Silviuu24/Proiect-uC-Termostat-Camera/Tema_04_Etaje_de_Alimentare_si_Analiza_Microcontrolerelor/Imagini/Pini_PIC16F877A.jpg

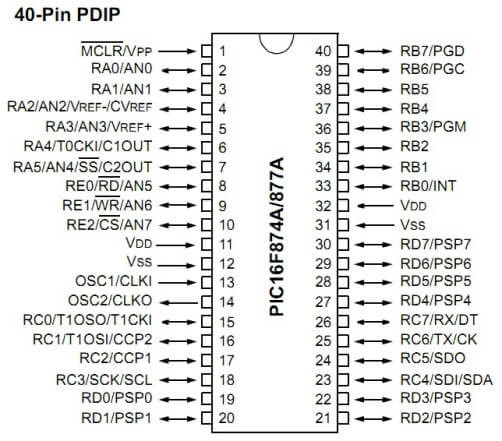
Tema_04_Etaje_de_Alimentare_si_Analiza_Microcontrolerelor/Imagini/Pini_PIC16F877A.jpg
