Silviuu24/Proiect-uC-Termostat-Camera/README.md

# Proiect-uC-Termostat-Camera
Proiect universitar (Anul III) - Microprocesoare: Proiectarea și simularea iterativă a unui termostat de cameră digital.
