Silviuu24/Proiect-uC-Termostat-Camera/Tema_06_Releu/Releu.pptx

## Implementarea Releului și Logica Software pentru Controlul cu Histereză

Nume: Șișca Silviu-Claudiu
An III, gr. 2133

## Cuprins

1. Cerința proiectului
2. Implementarea sistemului de comandă
3. Logica de comandă a butoanelor
4. Algoritm de control – Histereza
5. Simulări

## 1. Cerința proiectului

- Implementare sistem de comandă
- Implementare Butoane
- Cod C & Assembly

## 2. Implementarea sistemului de comandă

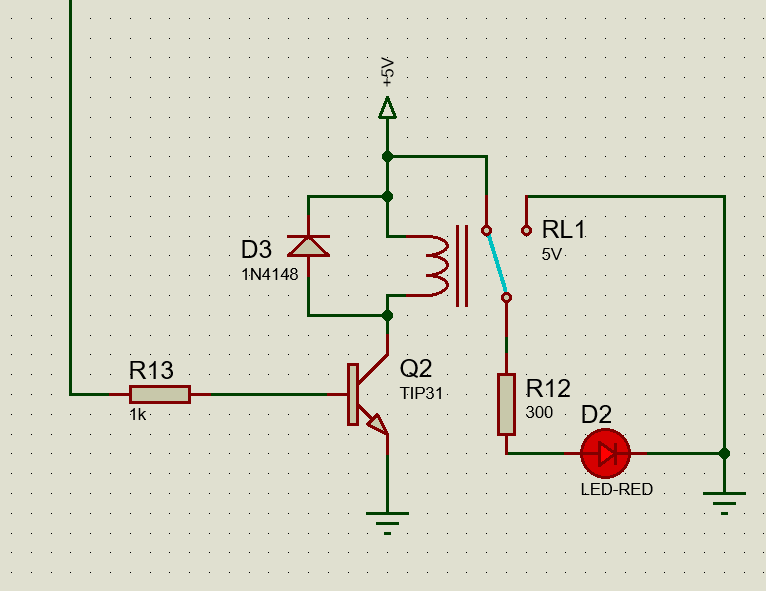
[picture p2: figure]

Tranzistor de comutație
Rezistență de bază
Dioda de protecție
Circuit de sarcină simulat

## 3. Logica de comandă a butoanelor

Modifică valoarea de referință
Limitare valoare de referință: 10°C - 30°C
2 întreruperi
Necesită implementare Debouncing

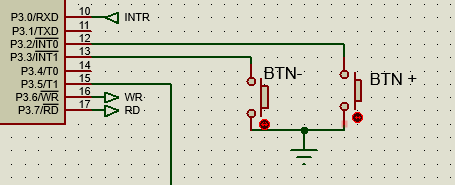
[picture p3: figure]

## 3. Logica de comandă a butoanelor

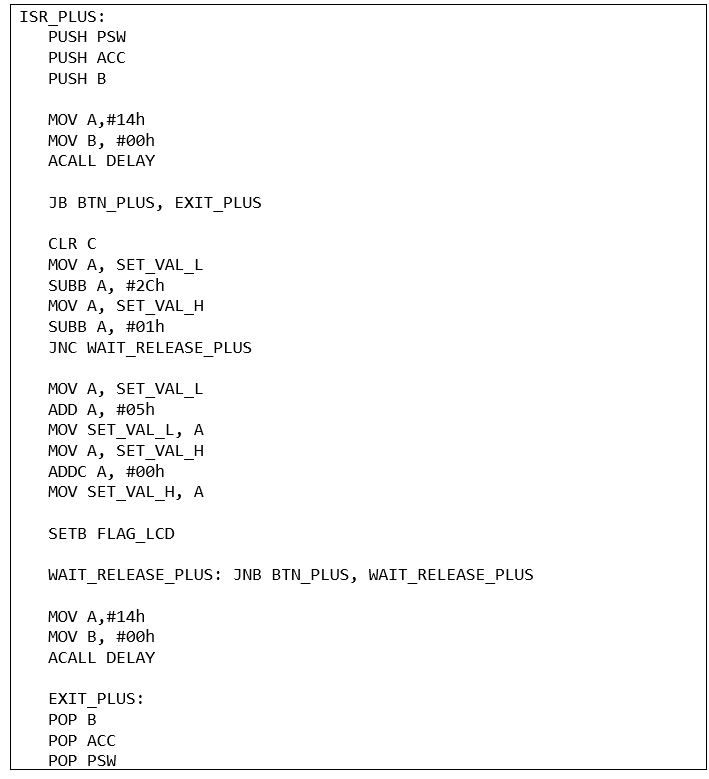
[picture p4: figure]
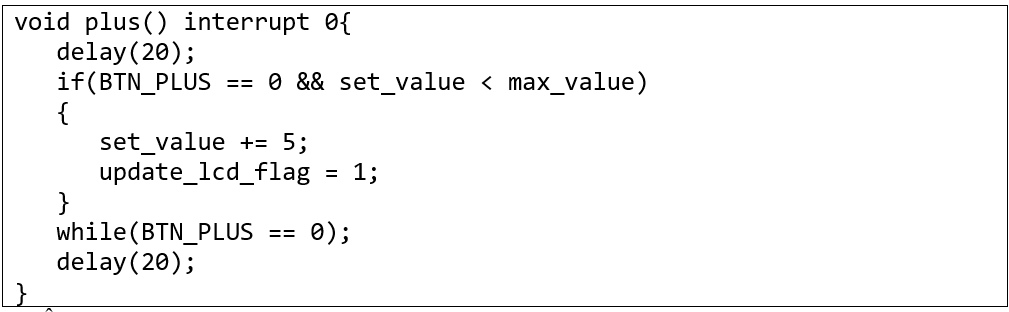
[picture p5: figure]

## 3. Logica de comandă a butoanelor

Dezactivare interrupt

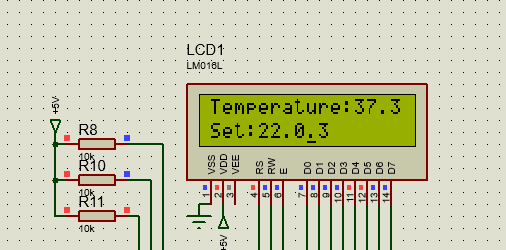
[picture p6: figure]

## 4. Algoritm de control - Histereza

±0.5°C
în C, structură decizională ‘if-else if’
în Assembly, scădere cu împrumut și verificare Carry Flag

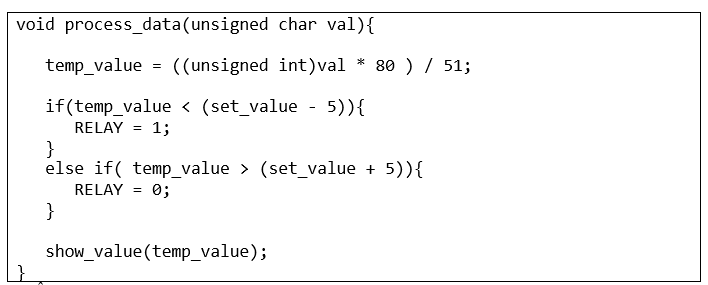
[picture p7: figure]

## 5. Simulări

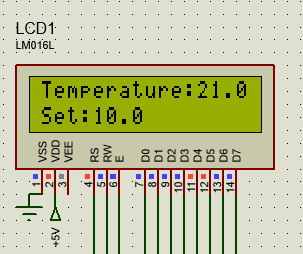
[picture p8: figure]
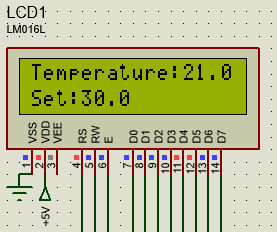
[picture p9: figure]

## 5. Simulări

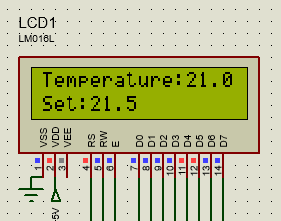
[picture p10: figure]
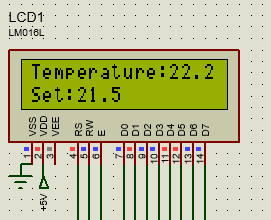
[picture p11: figure]
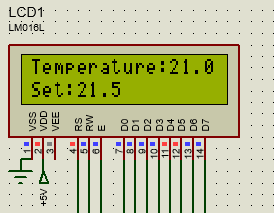
[picture p12: figure]
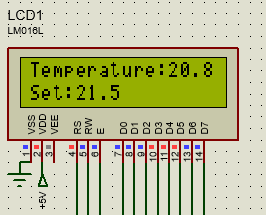
[picture p13: figure]
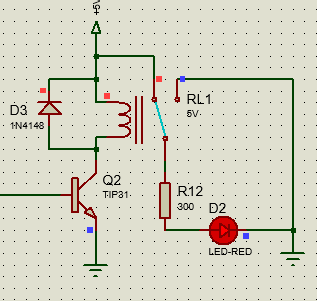
[picture p14: figure]
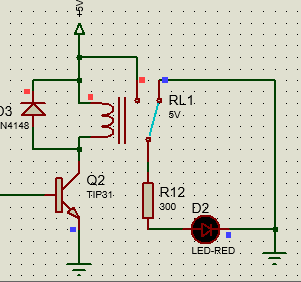
[picture p15: figure]
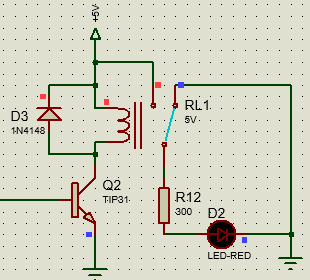
[picture p16: figure]
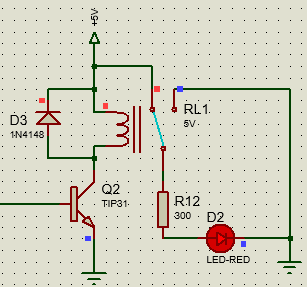
[picture p17: figure]

## Slide 11

Vă mulțumesc pentru atenție!
