Silviuu24/Proiect-uC-Termostat-Camera/Tema_05_uC_Code/uC_Code.pptx

## Sistem de Achiziție, Procesare și Afișare a Temperaturii folosind Microcontrolerul 8051

Nume: Șișca Silviu-Claudiu
An III, gr. 2133

## Cuprins

1. Cerința proiectului
2. Diagrama bloc de funcționare
3. Preluarea datelor de la ADC
4. Interpretarea datelor
5. Afișarea datelor pe LCD
6. Simulări

## 1. Cerința proiectului

- Cod C & Assembly
- Preluarea, interpretarea și afișarea datelor

## 2. Diagrama bloc de funcționare

- 2 etape principale
  - Etapa de inițializare
  - Bucla principală de funcționare

## Slide 5

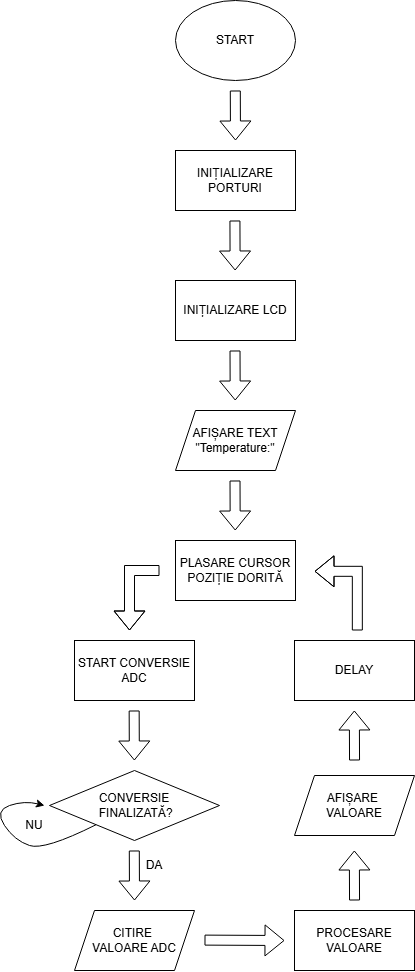
[picture p18: figure]

## 3. Preluarea datelor de la ADC

3 pași consecutivi
Începere conversie
Polling pin întrerupere
Activare ieșire ADC & citire date

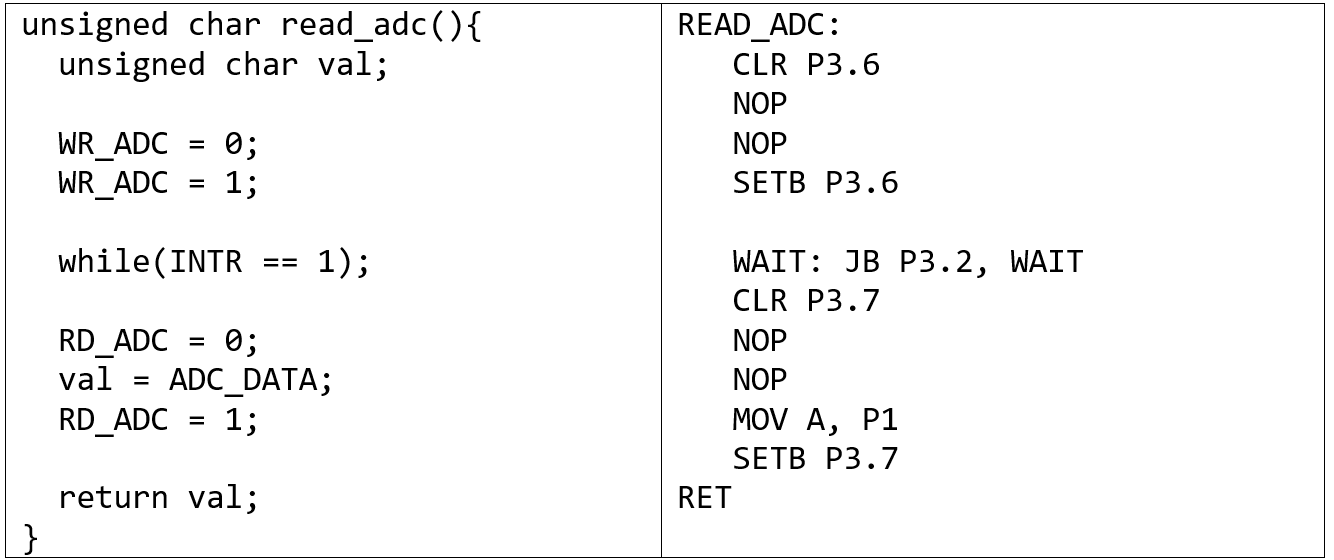
[picture p19: figure]

## 4. Interpretarea datelor

ADC_(out) ∈ [0; 255]
Temp ∈ [0; 40] °C
T_(zecimi) = (ADC_(out) ∗400)/255=(ADC_(out) ∗80)/51
T_(zecimi) ∈ [0; 400]

EX: T_(zecimi) = 256 => 25.6 °C

## 5. Afișarea datelor pe LCD

Formatare ASCII
Inserarea caracterului ‘.’
Afișare ‘ ’ în loc de ‘0’ dacă Temp < 10 °C
Ex: Temp=5.6 °C, afișăm “ 5.6”, nu “05.6”

## 6. Simulări

Temperatură Senzor [°C] | Temperatură Afișată pe LCD | Eroare [°C]
16.0 | 16.0 | 0.0
16.2 | 16.1 | - 0.1
16.4 | 16.4 | 0.0
16.6 | 16.6 | 0.0
16.8 | 16.7 | - 0.1
17.0 | 17.0 | 0.0

## 6. Simulări

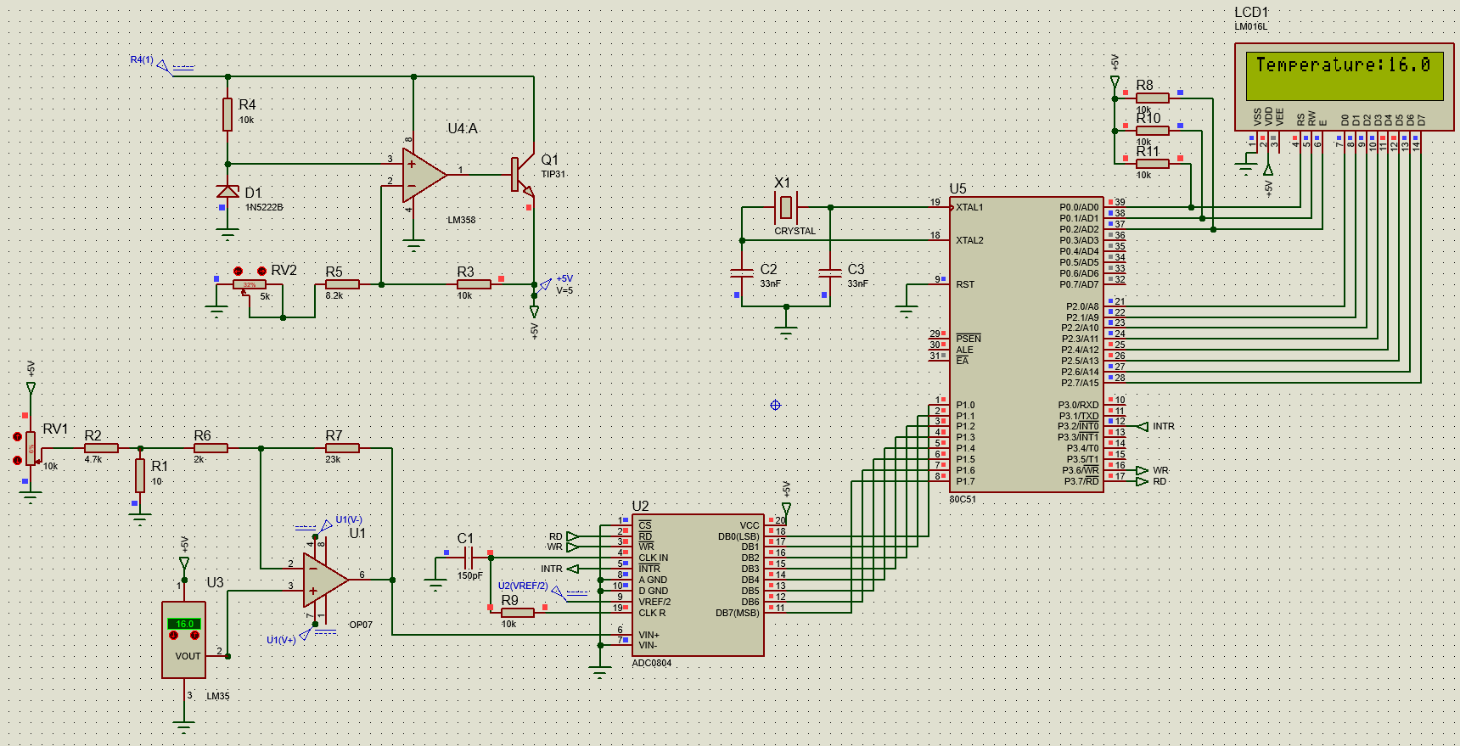
[picture p20: figure]

## 6. Simulări

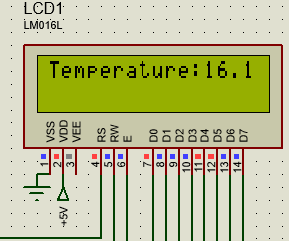
[picture p21: figure]
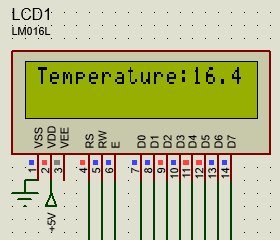
[picture p22: figure]
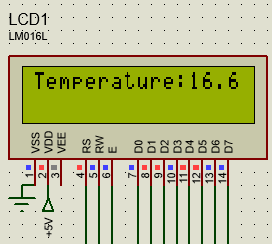
[picture p23: figure]
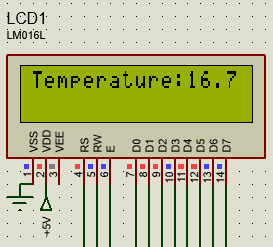
[picture p24: figure]
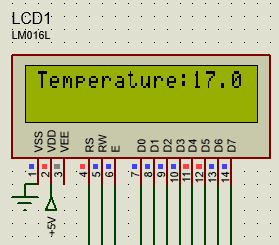
[picture p25: figure]

## 7. Concluzii

Obiectiv îndeplinit cu succes
Eroare de ±0.1°C datorată ADC-ului pe 8 biți

## Slide 13

Vă mulțumesc pentru atenție!
