Silviuu24/Proiect-uC-Termostat-Camera/Tema_02_Achizitie_Conditionare_Afisare/Sistem de achiziție, condiționare și afișare.pptx

## Sistem de achiziție, condiționare și afișare a temperaturii

Nume: Șișca Silviu-Claudiu
An III, gr. 2133

## Cuprins

1. Cerința proiectului
2. Etajul de achiziție: LM35
3. Etajul de condiționare
4. Etajul de conversie și afișare: ADC0804
5. Simulări

## 1. Cerința proiectului

- Măsurarea temperaturii cu senzorul analogic LM35 (0°C - 40°C)
- Realizarea unui circuit de condiționare
- Conversia analog-digitală a semnalului
- Afișarea valorii digitale în format hexazecimal

## 2. Etajul de achiziție: LM35

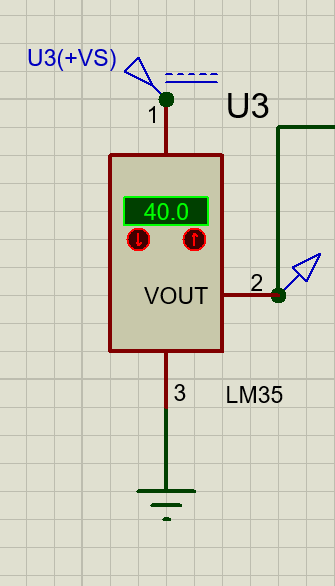
[picture p32: figure]

- Factor de scalare liniar: 10mV/°C
- Tensiunea de ieșire: 0V – 0.4V

## 3. Etajul de condiționare

- Amplificator neinversor
- Factor de amplificare A_v =12.5
- Compensare de offset (maxim 122mV)
- Tensiunea de ieșire: 0V – 5V

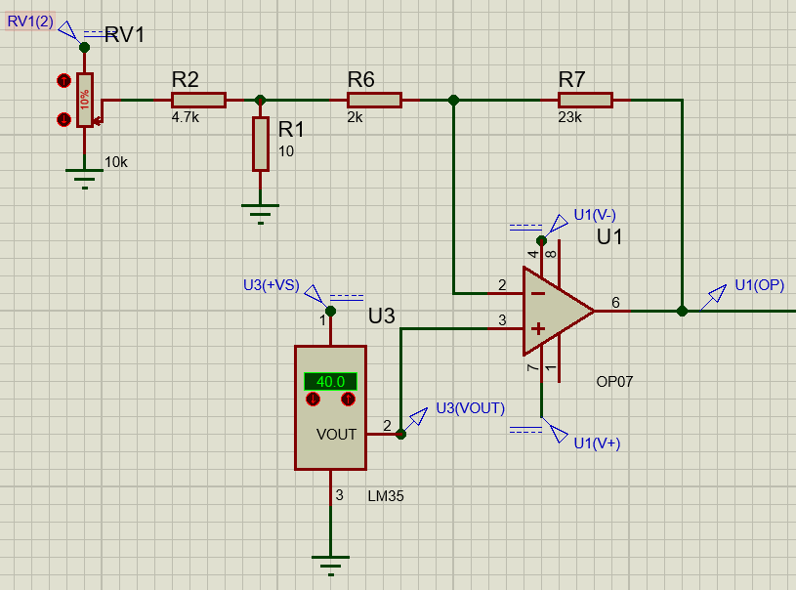
[picture p33: figure]

## 4. Etajul de conversie și afișare: ADC0804

- Convertor analog-digital cu RAS
- 8 biți
- V_(LSB) ≃19.5mV
- f_(CLK) ≃626kHz
- T_(conv) ≃116µs
- Interval valori ieșire: 00h - FFh

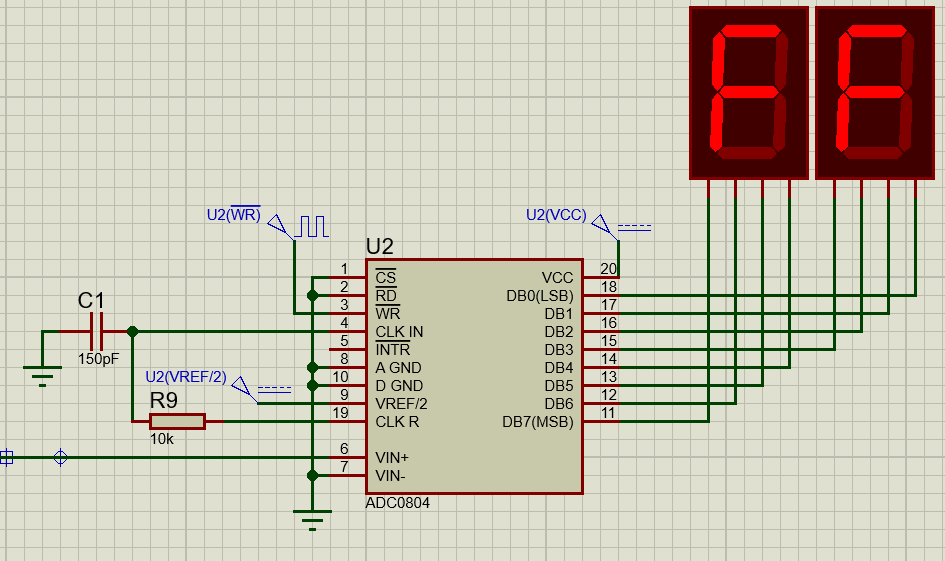
[picture p34: figure]

## 5. Simulări

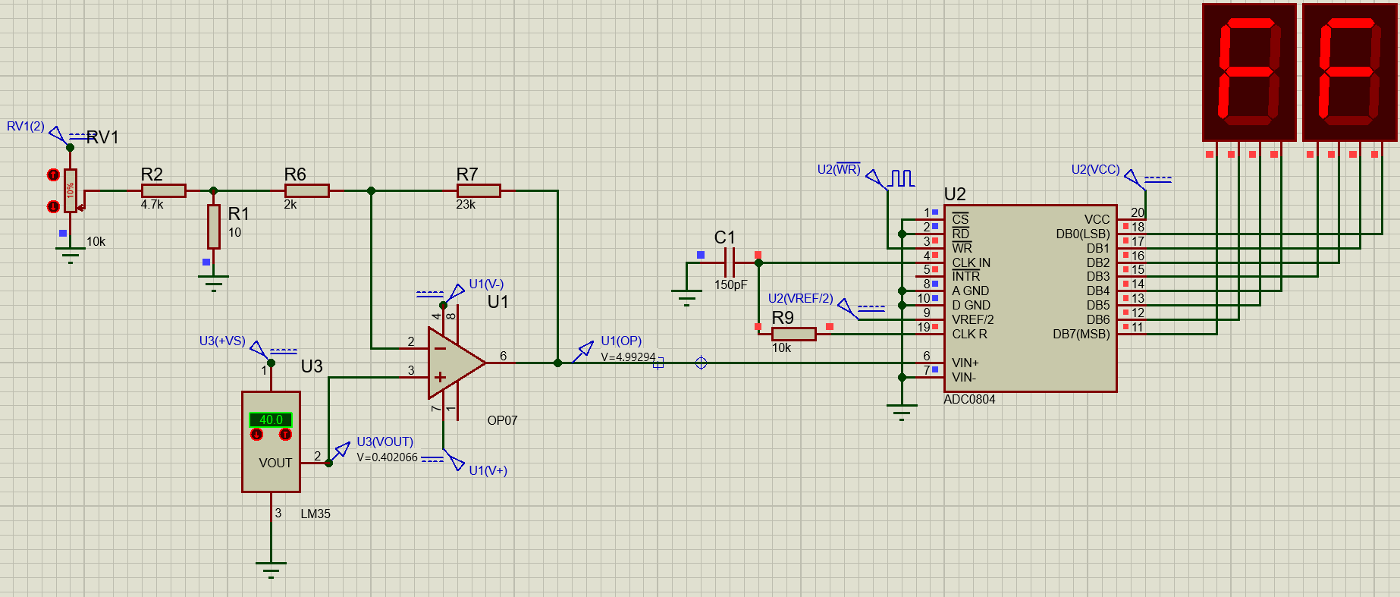
[picture p35: figure]

## 5. Simulări

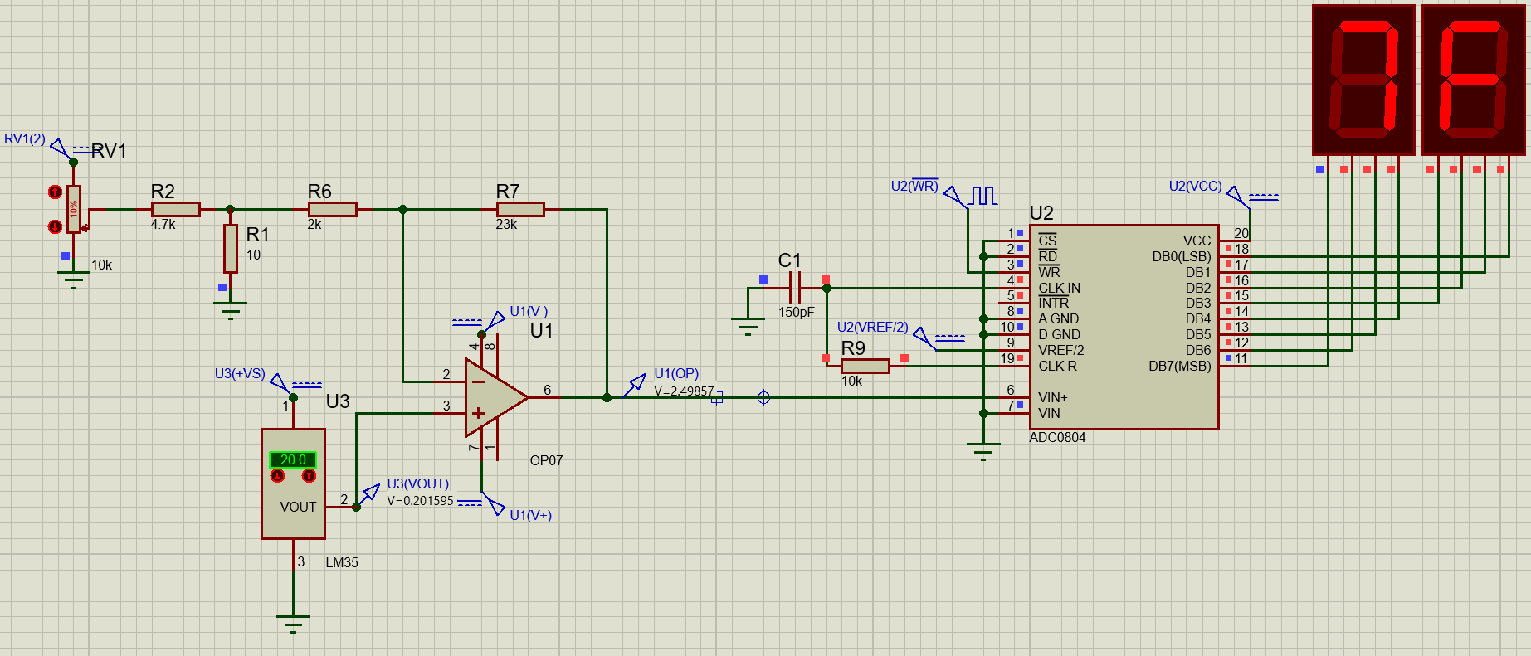
[picture p36: figure]

## 5. Simulări

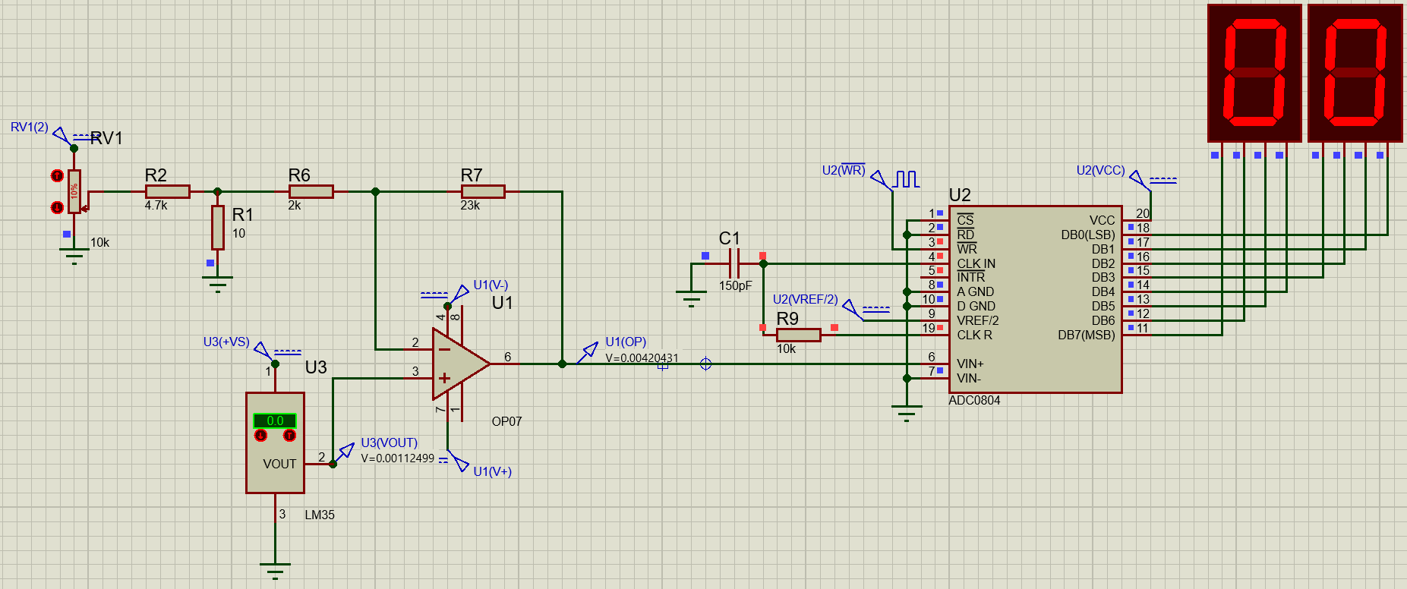
[picture p37: figure]

## Slide 10

Vă mulțumesc pentru atenție!
