Silviuu24/Proiect-uC-Termostat-Camera/Tema_03_LCD_16x2/Comanda_Digitala_Modul_LCD_16x2.pptx

## Comanda Digitală a Modulului LCD 16x2 prin Stări Logice

Nume: Șișca Silviu-Claudiu
An III, gr. 2133

## Cuprins

1. Cerința proiectului
2. Principiul de funcționare (hardware)
3. Avantaje și dezavantaje
4. Schema Circuitului
5. Simulare
5.1. Algoritm de inițializare
5.2. Scrierea pe primul rând (RS = 1)
5.3. Schimbarea rândului
5.4. Finalizarea afișării
6. Bibliografie

## 1. Cerința proiectului

- Studiul funcționalității ecranului LCD 16x2
- Avantaje / Dezavantaje
- Afișare “Nume Prenume / Grupa 2133”

## 2. Principiul de funcționare (hardware)

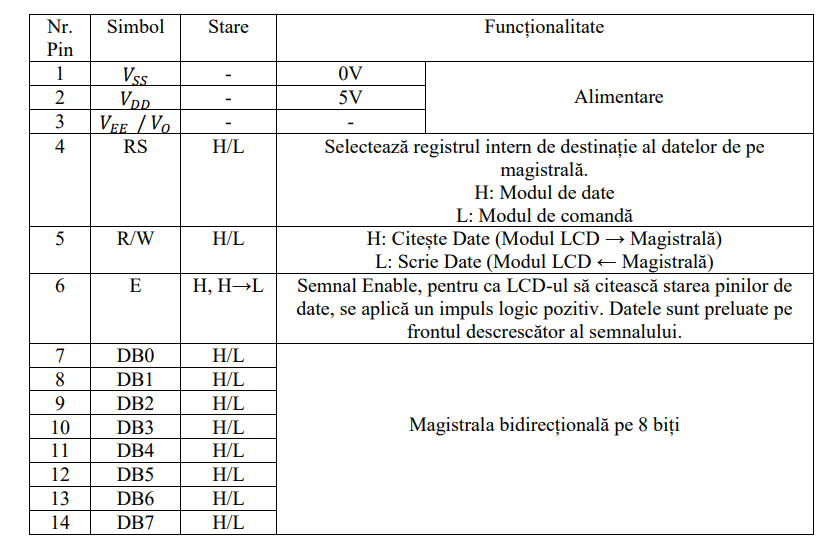
[picture p79: figure]

- Magistrală pe 8 biți
- 3 pini de control

## 3. Avantaje și dezavantaje

Avantaje | Dezavantaje
Afișare alfanumerică | Consum ridicat de pini I/O
Consum redus de energie | Limitări grafice
Standardizare | Inițializare complexă
| Timpi de așteptare

## 4. Schema Circuitului

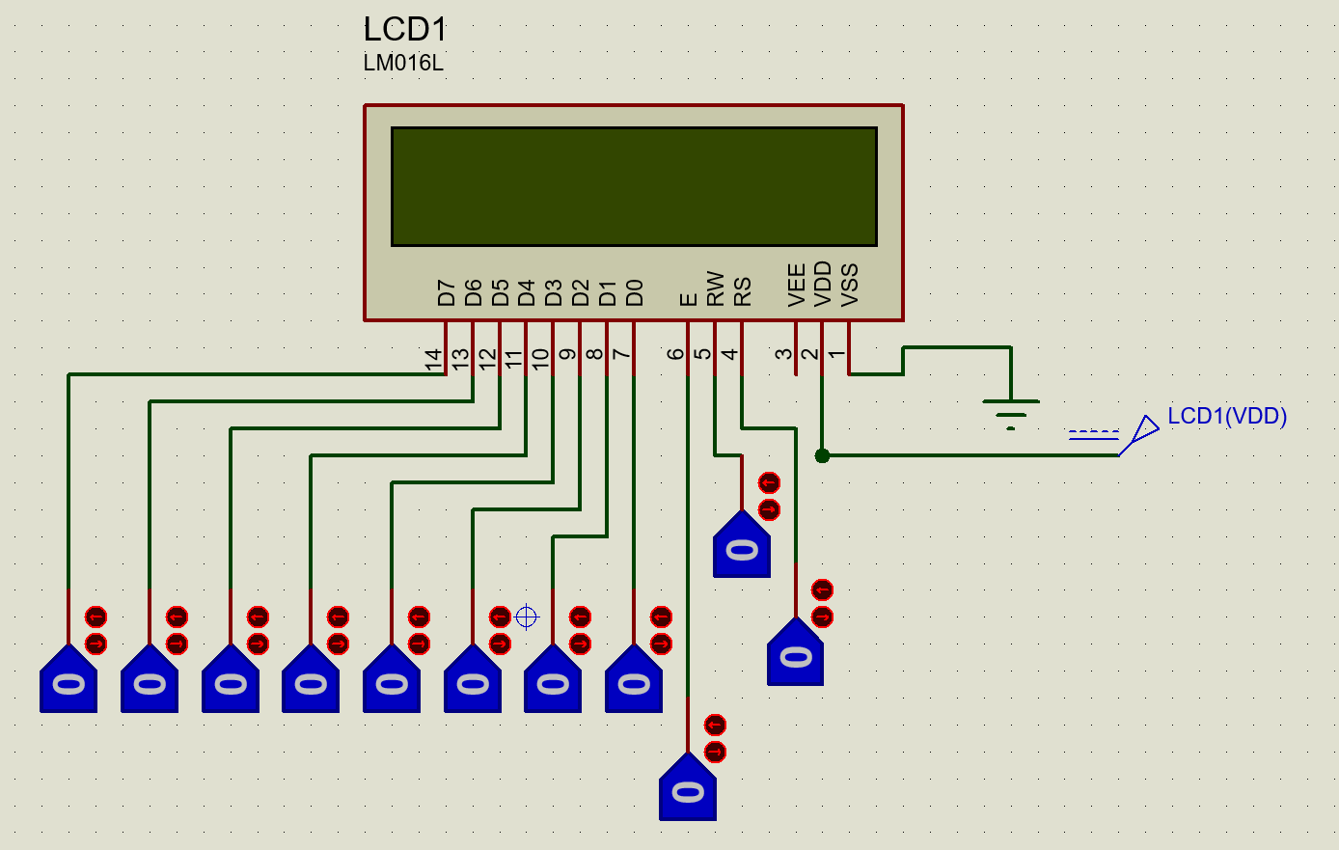
[picture p80: figure]

- *Pinul 3 (VEE – contrast) este gestionat automat de simulator

## 5. Simulare

- Algoritm de inițializare
- Scrierea pe primul rând
- Schimbarea rândului
- Finalizarea afișării

## 5.1. Algoritm de inițializare

RS = 0
- Function Set (0x38) – 8 biți, 2 linii
- Display ON (0x0E)
- Clear Display (0x01)
- Entry Mode (0x06) – incrementare automată

## 5.2. Scrierea pe primul rând (RS = 1)

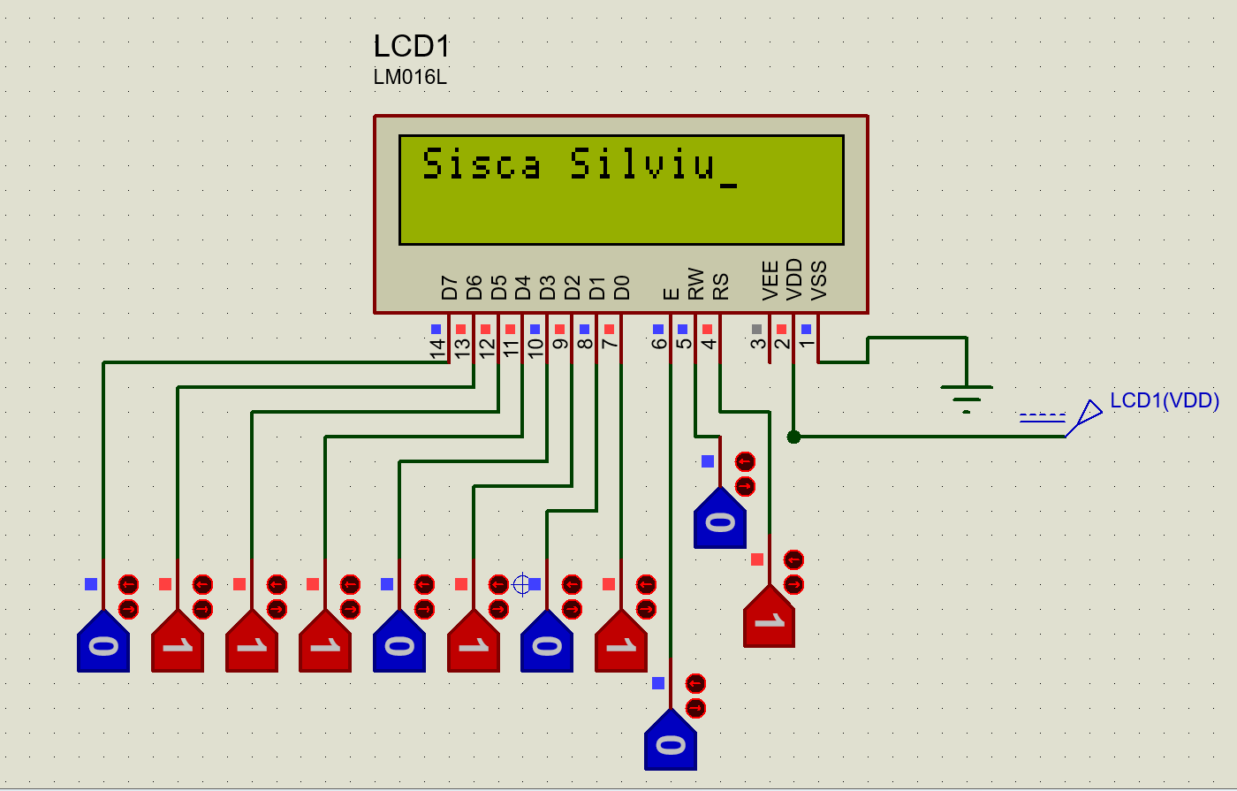
[picture p81: figure]
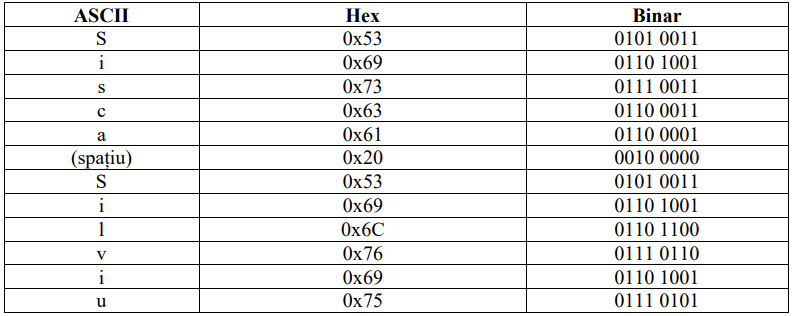
[picture p82: figure]

## 5.3. Schimbarea rândului

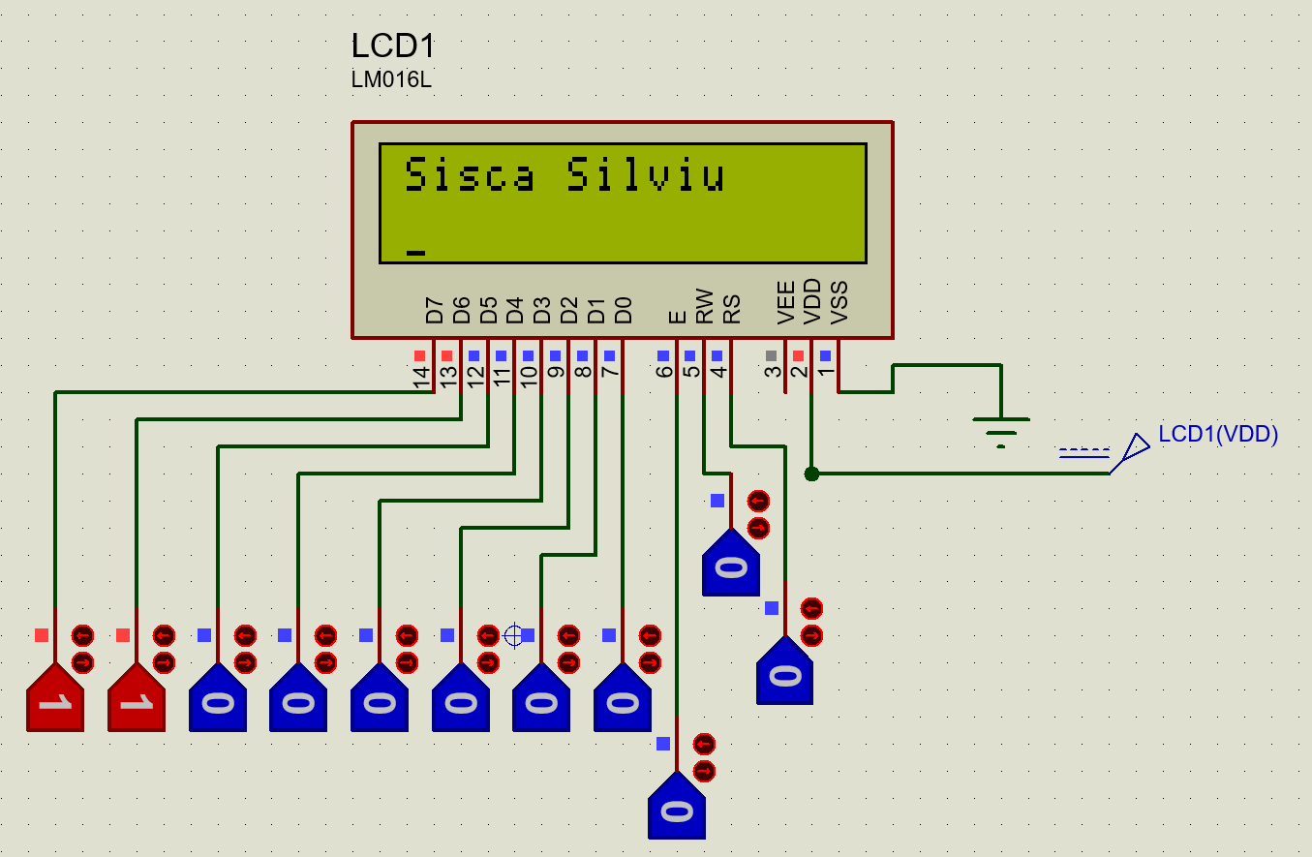
[picture p83: figure]

RS = 0
- Set DDRAM Address (0xC0)

## 5.4. Finalizarea afișării

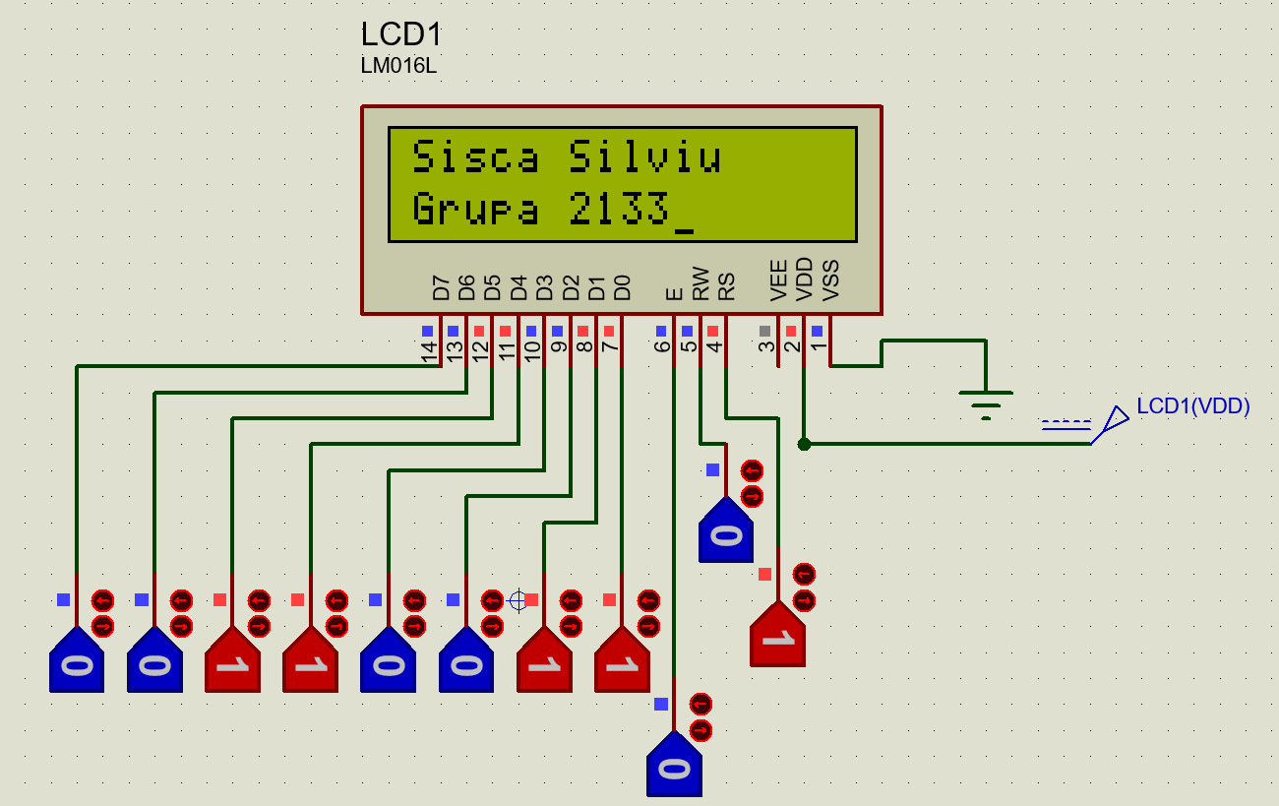
[picture p84: figure]
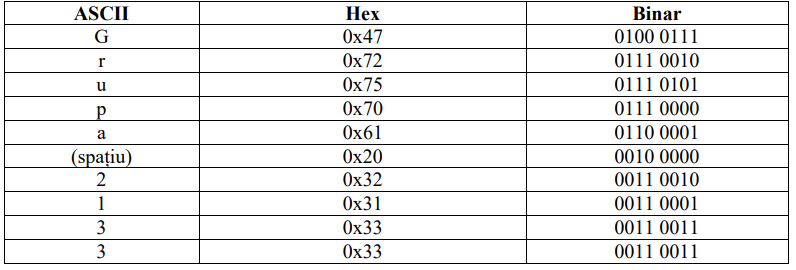
[picture p85: figure]

## 6. Bibliografie

- [1] Hitachi, „LM016L Dot Matrix Liquid Crystal Display Module”, Datasheet, https://digsys.upc.edu/csd/chips/classic/LM016L_Hitachi.pdf .
- [2] Innovation of Engineers, „LCD 16×2 (LM016L)”, ECE Study Centre, https://embeddedcenter.wordpress.com/ece-study-centre/display-module/lcd-16x2-lm016l/ .

## Slide 13

Vă mulțumesc pentru atenție!
