Silviuu24/Proiect-uC-Termostat-Camera/Tema_05_uC_Code/Imagini/Simulare_16.4_grade.png

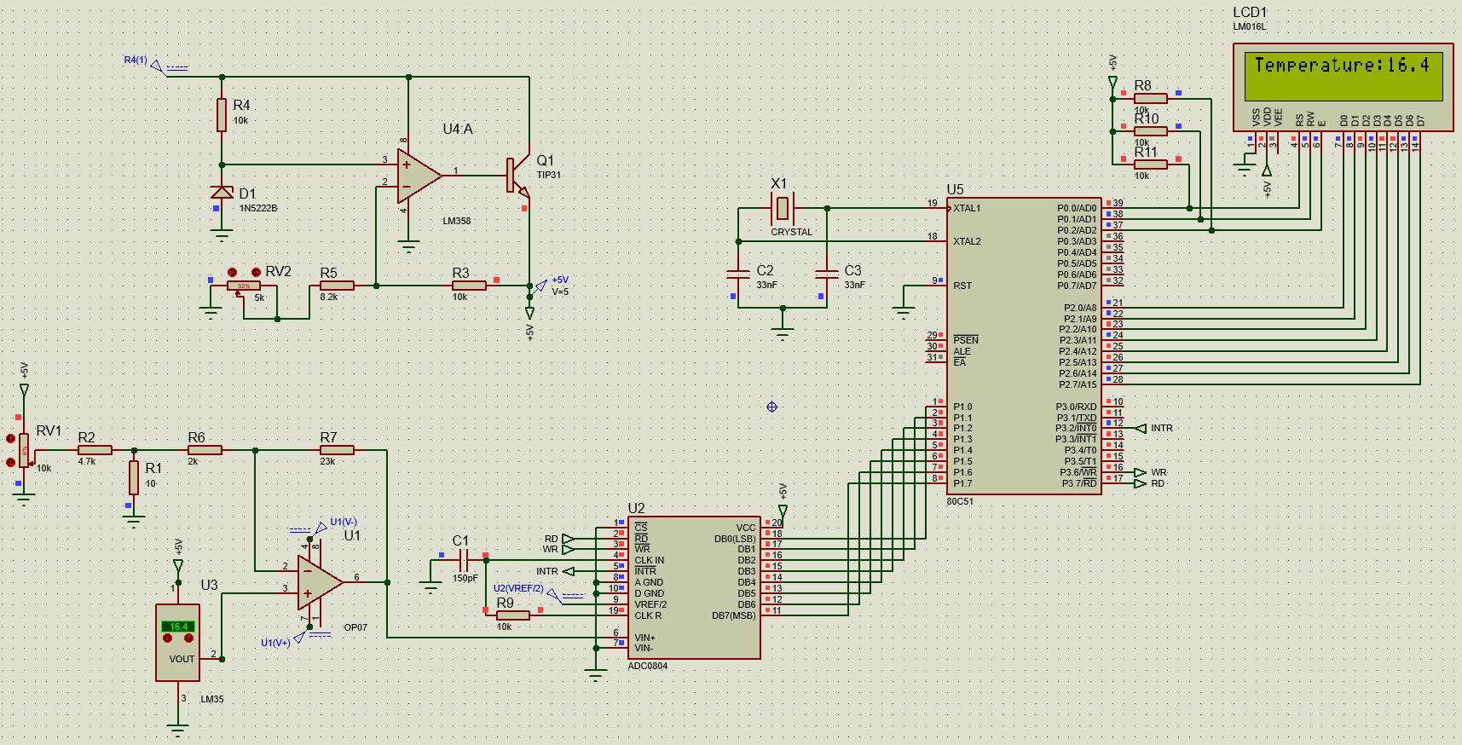
Tema_05_uC_Code/Imagini/Simulare_16.4_grade.png
