Silviuu24/Proiect-uC-Termostat-Camera/Tema_05_uC_Code/Imagini/Simulare_17.0_grade.png

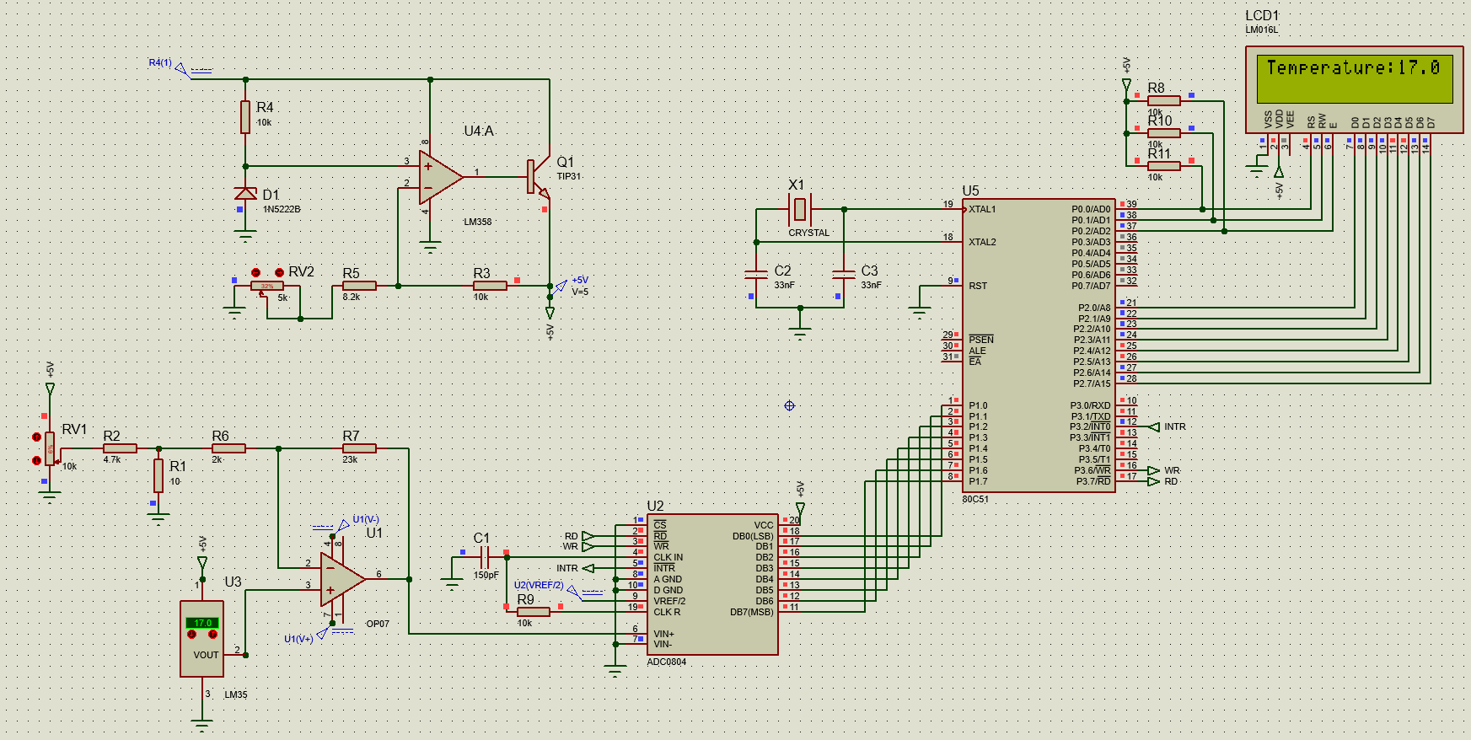
Tema_05_uC_Code/Imagini/Simulare_17.0_grade.png
