Silviuu24/Proiect-uC-Termostat-Camera/(list of files, drawings)

Other design files:
Tema_02_Achizitie_Conditionare_Afisare/Simulari_Proteus/circuit_achizitie_conditionare_afisare.pdsprj
Tema_03_LCD_16x2/Simulari_Proteus/lcd_16x2.pdsprj
Tema_04_Etaje_de_Alimentare_si_Analiza_Microcontrolerelor/Simulari_Proteus/etaje_de_alimentare.pdsprj
Tema_05_uC_Code/Simulari_Proteus/circuit_termostat.pdsprj
Tema_06_Releu/Simulari_Proteus/circuit_termostat.pdsprj
